DennisM00/sensors/README.md

## Installation

1. clone repository:
   ```bash
   git clone https://github.com/DennisM00/sensors.git
   cd sensors

2. excecute bootstrap.sh:
    it will clone esp-matter.git and will apply necessary modifications
