DennisM00/sensors/Thesis/Lastenheft Bachelorarbeit.xlsx

Requirements Specification ("Lastenheft")
Project: | Bachelorarbeit Dennis Makein
Supplier: | Dennis Makein
Date: | 2025-01-31
List of Requirements
ID | Priority (MUST / SHALL / CAN) | Description | Realisation
R0.1 | MUST | The system is operational in its current state. | Funktioniert | TRUE
R0.2 | MUST | The whole code is documented and well-structured. | Kommentare + Unterfunktionen | TRUE
R0.3 | MUST | The code is version-controlled with Git. |  | TRUE
R0.4 | MUST | The system and the contributions are documented in a thesis. | Generelle Dokumentation gemeint | TRUE
R0.5 | MUST | All results are documented with the respective revision of the code they have been created with. |  | TRUE
R0.6 | SHALL | Project management and collaboration is done via a central Git web platform. | Github | TRUE
R1.1 | MUST | A summary and review of the state-of-the-art systems and standards for multi sensor nodes in smart home applications exists, in particular depicting their technology, security, safety, and administation aspects. | Homattic shelly (Produkte am Markt) (Kap2_3) | FALSE
R1.2 | MUST | The systems and standards from R1.1 are characterized and compared to each other. | Tabelle R1.1 | FALSE
R1.3 | MUST | The state-of-the-art of available, relevant smart home protocols and their features, requirments, and license exists. | Kap2_2 | TRUE
R1.4 | MUST | The state-of-the-art of available open source hardware and software solutions for microcontroller based IoT nodes is depicted. | Kap2_1 | TRUE
R2.1 | SHALL | The theoretical background and the basic concepts of MQTT are summarized and depicted. | Kap3_5 | TRUE
R2.2 | SHALL | The theoretical background and the basic concepts of the Matter smart home standard are summarized and depicted. | Kap3_6 | TRUE
R3.1 | MUST | A sensor node based on an ESP32 microcontroller for measuring temperature and humidity exists. |  | TRUE
R3.2 | MUST | The sensor node from R3.1 is operational, tested, and well-documented. | Kap4_3 | TRUE
R3.3 | MUST | The sensor node from R3.1 provides a standard communication interface. | I2C + Protokoll dargestellt (Kap3_2+3_3+4_3) | TRUE
R3.4 | MUST | The communication interface from R3.3 is operational, tested, and well-documented. | Operatinal +; documented + | TRUE
R3.5 | SHALL | The communication interface from R3.3 is based on the Matter standard. | Esp_matter.h /.cpp Dateien | TRUE
R3.6 | CAN | The sensor node from R3.1 provides further data from attached sensors. | CO2 + PIR | TRUE
R4.1 | MUST | A custom PCB for the sensor node from R3.1 is designed. | Platinenentwurf | TRUE
R4.2 | SHALL | The PCB from R4.1 is manufactured and equipped. | Über Elektrowerkstatt | FALSE
R4.3 | SHALL | The PCB from R4.1 is operational, tested, and well-documented. |  | FALSE
R4.5 | SHALL | The complete sensor node with the custom PCB from R4.1 is evaluated with respect to power and energy consumption. | Kurze leiterbahnen etc. | FALSE
R4.4 | SHALL | The complete sensor node with the custom PCB from R4.1 is evaluated with respect to expandability. | Pin Header Reserve | TRUE
R5.1 | MUST | A smart home server is implemented, tested, and documented. | HomeAssistant | TRUE
R5.2 | MUST | The smart home server from R5.2 is based on an open source technology and self-hosted. | HomeAssistant | TRUE
R5.3 | MUST | The available communication interfaces and bindings from R5.1 are documented. | Matter Bindung aber nur wifi | TRUE
R5.4 | MUST | The sensor node from R3.1 is connected to the smart home server from R5.1. |  | TRUE
R5.5 | MUST | An example use case is defined and documented. | Weiterverwendung der Daten | TRUE
R5.6 | SHALL | More sophisticated example use cases are defined and documented. | Mehrere Beispiele | FALSE
R5.7 | SHALL | The connection between the sensor node from R3.1 and the smart home server from R5.1 is established via Matter. |  | TRUE
R6.1 | MUST | The smart home system consisting of R3.1, R4.1 and R5.1 is assembled and operational. |  | TRUE
R6.1 | MUST | The structure of the complete smart home system from R6.1 is documented as a block diagram. | Wie bei matter Webseite anlegen | FALSE
R6.3 | MUST | A test setting for the smart home system from R6.1 based on the use cases defined in R5.5 and R5.6 is defined and documented. | Beispielnutzung (Büro) | TRUE
R6.2 | MUST | The smart home system from R6.1 is evaluated with the test setting from R6.2 and the results are documented. |  | FALSE
