DennisM00/sensors/(list of files, drawings)

Other design files:
PCB/PCB-neu_2025-06-15.PCB
