DennisM00/sensors/(commit log)

2025-04-09 new file: CMakeLists.txt new file: main/CMakeLists.txt new file: main/app_main.cpp new file: main/app_openthread_config.h new file: main/drivers/ccs811_hyt271_d6t1a01_i2c.cpp new file: main/drivers/c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
2025-06-01 PCB Dateien
    [PCB-verbesserung_2025-05-29.PCB, PCB-verbesserung_2025-05-29.PCB.brd, PCB-verbesserung_2025-05-29.pcbdoc]
2025-06-02 PCB aktualisiert
    [PCB-verbesserung_2025-05-29.PCB, PCB-verbesserung_2025-05-29.pcbdoc, PCB-verbesserung_2025-06-02.brd, PCB-verbesserung_2025-06-02.pcbdoc, PCB_PCB-verbesserung_2025-06-02.json]
2025-06-03 nicht benötigte verbindung entfernt
    [PCB-verbesserung_2025-06-03.brd]
2025-06-15 PCB-Update (->Anschlüsse auf Bottom-Layer)
    [PCB-neu_2025-06-15.PCB, PCB-neu_2025-06-15.PCB.brd, PCB-neu_2025-06-15.pcbdoc, PCB-verbesserung_2025-06-02.pcbdoc, PCB-verbesserung_2025-06-03.brd, PCB_PCB-verbesserung_2025-06-02.json]
2025-06-15 Update Thesis
    [Lastenheft Bachelorarbeit.xlsx]
2025-06-21 fehlen: Einleitung, fazit, R1.1 (+1.2), R6.2, PCB docs, Kap 5 Ergebnisse und Auswertung (persönliche Reflexion)
2025-06-21 Update Lastenheft
    [Lastenheft Bachelorarbeit.xlsx]
2025-06-24 PCB Update Lochdurchmesser auf 0,6+
    [PCB-neu_2025-06-15.pcbdoc, PCB-neu_2025-06-24.PCB, PCB-neu_2025-06-24.PCB.brd, PCB-neu_2025-06-24.pcbdoc]
2025-07-04 neue PCB
    [PCB-neu_2025-06-24.PCB, PCB-neu_2025-06-24.pcbdoc, PCB-neue-Widerstände_2025-07-04.PCB.brd, PCB-neue-Widerstände_2025-07-04.pcbdoc]
2025-07-04 neue Widerstände + vergrößeren der ESP32C6 Löcher
    [PCB-neue-Widerstände_2025-07-04.PCB.brd, PCB-neue-Widerstände_2025-07-04.pcbdoc]
2025-07-12 wieder hinzufügen der driver
2025-07-28 PCB Versionen
    [Multisensor-Verbesserung.PCB.brd, Multisensor.PCB.brd, PCB-neue-Widerstände_2025-07-04.pcbdoc]
